dmcmd/STEELHAUS/STEELHAUS_User_Manual.docx

STEELHAUS

Heat Treat Kiln Controller

User Manual

For garage knifemakers and bladesmiths who want precise, repeatable heat treatment without a PhD in control systems.

# What Is STEELHAUS?

STEELHAUS is a touchscreen controller for your heat treat kiln. It lives on a Raspberry Pi inside or next to your oven, reads the thermocouple temperature through an ESP32, and controls the SSR (solid-state relay) that switches the heating element on and off.

The goal is simple: you tell it what temperature you want and it holds that temperature accurately and reliably, whether you are tempering a blade at 350°F, normalizing at 1475°F, or running a complex multi-step hardening program for D2 tool steel.

Unlike a basic PID controller that you buy off the shelf, STEELHAUS learns your specific oven over time. Every time you run it, it gets a little smarter about how your oven behaves, and it uses that knowledge to reach temperature faster, hold more precisely, and recover better when you open the door.

## What you need to know upfront

You do not need to understand PID control, relay autotuning, or thermal modeling to use this controller. The defaults work. The autotuning handles the math. This manual will explain why things work the way they do, but the short version is: run the setup steps once and then just use it.

The UI runs in a web browser. You access it by pointing any browser on your network to your oven's address. It is designed to be used on a touchscreen mounted on or near the oven, but it works fine on a phone or laptop too.

# Accessing the Controller

The controller runs as a web application on your Raspberry Pi. You access it through any web browser on the same network.

## Local network access

From the shop touchscreen | http://kiln.local:5000
From your phone or laptop | http://kiln.local:5000
If kiln.local does not work | Use the Pi's IP address instead, e.g. http://192.168.1.x:5000

## Remote access via Tailscale

If you have Tailscale installed on your Pi, you can access the controller from anywhere in the world using the Tailscale IP address. This lets you check on your oven from the house while a long temper cycle is running. See the Settings tab for Tailscale status.

NOTE: The controller is running whenever the Pi is powered on. It does not need to be open in a browser to control the oven.

## Connection indicator

The top-right corner of the interface shows a dot and the word LIVE (green) or CONNECTING (orange). If you see CONNECTING for more than a few seconds, check that the Pi is powered on and connected to the network.

# Dashboard Tab

The Dashboard is your main operating screen. Everything you need to run the oven day-to-day is here.

## Temperature display

The large number in the center of the screen is the current oven temperature. The color tells you at a glance what mode the oven is in:

- Blue — oven is cold or significantly below setpoint
- Orange — oven is at or near the setpoint
- Red — oven is approaching its maximum temperature limit

Below the main temperature you will see three smaller values:

SETPOINT | The target temperature the controller is trying to reach or hold
OUTPUT | The current heater output as a percentage (0% = off, 100% = full power)
COLD JXN | Cold junction temperature — the temperature at the thermocouple connection point on the ESP32. Normal to see 70–90°F when the oven is hot.

## Heater output bar

The orange bar below the temperature readings shows heater output visually. A label underneath tells you what phase the controller is currently in:

⚡ FULL POWER | Running at 100% to heat up as fast as possible
↘ Ramping Down | In the approach zone, reducing power as it nears setpoint
— Cruise | Holding at a steady intermediate output just before PID takes over
◎ PID Active | PID is in control, making fine adjustments to hold setpoint precisely
🔥 Door Recovery | Running at recovery boost power after door was opened
Ramp Rate | Running a program ramp segment, rate controller is active

## Manual Setpoint

Below the output bar is the Manual Setpoint box. This is how you set a temperature for manual operation (not using a program). Tap the number to open the numpad, enter your target temperature in degrees Fahrenheit, and confirm with SET. The oven will begin heating toward that temperature immediately once you press START.

NOTE: The numpad pre-fills with the current setpoint. Just start pressing digits — the first digit press automatically clears the old value so you do not have to hit CLEAR first.

## START / STOP button

The large button below the setpoint starts and stops the heater. When the heater is running it turns red and shows STOP. Press it to cut power, drop the contactor, and return the oven to manual mode.

NOTE: Pressing STOP during a program run aborts the program. The program itself is not deleted, just the current run.

## Contactor indicator

Below the START/STOP button is the Contactor status. The contactor is a heavy-duty relay that physically disconnects mains power from the heating element. When it shows green (Energized — AC live at SSRs), the element can be powered. When it shows red (De-energized — AC isolated), the element is completely disconnected from mains power regardless of what the SSR is doing. The contactor is always de-energized when the oven is stopped.

## Active PID Zone

When the heater is running, a section below the contactor shows the active PID zone — the set of tuning parameters the controller is currently using. This updates automatically as the oven moves through different temperature ranges.

## Program status (when a program is running)

When a heat treat program is running, the dashboard shows a program status panel above the manual setpoint box. This includes:

- Program name and current state (running, paused, etc.)
- Overall progress bar
- A step-by-step list of every segment in the program, showing which step is active, which are complete, and which are upcoming
- A progress bar for the current step
- Elapsed and remaining time
- Pause, Resume, and Abort buttons

Completed steps show a green checkmark and fade out. The active step highlights in orange (ramp) or blue (soak). Upcoming steps are dim.

# Programs Tab

Programs let you automate multi-step heat treat sequences. Instead of babysitting the oven through a normalize, then reheat, then soak, then quench sequence, you define the steps once and let the controller handle the timing.

## What is a program?

A program is a sequence of segments. Each segment is either a Ramp or a Soak:

RAMP | Heat up or cool down at a controlled rate, measured in degrees per minute. Example: ramp to 1475°F at 10°F per minute.
SOAK | Hold at a specific temperature for a set time, or hold indefinitely (Continuous) until you manually abort.

A typical knifemaking heat treat program might look like:

1. Ramp to 1475°F at 15°F/min (bring oven to hardening temperature)
2. Soak at 1475°F for 10 minutes (normalize the steel)
3. Ramp to 1925°F at 10°F/min (bring to austenitizing temperature)
4. Soak at 1925°F for 5 minutes (then quench — you abort at this point)

## Built-in programs

STEELHAUS comes with four pre-loaded programs:

1084 High Carbon | Ramp to 700°F for stress relief, then ramp to 1475°F and soak 10 minutes. For 1084 carbon steel hardening.
D2 Tool Steel | Multi-stage ramp through 930°F, 1470°F, and 1850°F with soaks at each level. For D2 air-hardening tool steel.
Temper 375°F | Two 60-minute temper cycles at 375°F. For most carbon steels after hardening.
Normalize 1084 | Single ramp to 1600°F with a 10-minute soak. For stress relief before final heat treat.

You can use these as-is or as starting points for your own custom programs.

## Creating a new program

1. Tap + New Program at the top of the Programs tab.
2. Tap the Program Name field to open the keyboard. Type a name (e.g. AEB-L Harden).
3. Optionally tap Description to add notes.
4. Tap Add Ramp or Add Soak to add your first segment.
5. For each segment, set the target temperature and either the ramp rate (for ramps) or the hold time (for soaks).
6. Tap Save Program when done.

TIP: For the soak that ends with a quench, set it to Continuous. The program will hold at temperature until you tap Abort, at which point you pull the blade and quench.

## Editing a program

Tap any program in the list to open its detail view, then tap the pencil (edit) button. You can change the name, description, and any segment. Tap Save when done.

## Running a program

From the program list, tap the green play button next to the program you want to run. The controller switches to the Dashboard and begins the program immediately.

You can also open a program's detail view and tap Run Program from there.

## Ramp segments in detail

When a ramp segment is running, the rate controller takes over from the normal PID. It measures the actual rate of temperature rise using a rolling average of recent temperature readings, compares that to your target rate, and adjusts output to match. This means:

- The oven actually heats at the rate you specified, not just chases a moving setpoint
- If the oven is climbing faster than the target rate, output is reduced
- If it is climbing slower, output is increased

Before the ramp starts, the controller waits in preheat mode until the oven is already rising at least 20% of the target rate. This prevents the ramp clock from getting ahead of a cold oven.

## Soak segments in detail

When a ramp finishes and a soak begins, the controller looks up the thermal model (see Thermal Model section) to find out approximately what output is needed to hold that temperature. It seeds the PID with that value so there is no dip or overshoot at the transition.

## Continuous soak

A soak with Continuous enabled holds indefinitely. The program will not advance past it on its own. Use this for the final soak before a quench: when you are ready, tap Abort on the dashboard. The program ends, the oven shuts off, and you quench.

## Pausing and resuming

You can pause a running program using the Pause button on the dashboard. The timer stops and the oven holds at the current setpoint. Tap Resume to continue. Note that pausing during a ramp leaves the setpoint where it was — it will not back up when you resume.

## Aborting a program

The Abort button stops the program immediately. The heater is cut, the contactor drops, and the controller returns to a stopped state. The program itself is saved and can be run again.

# PID Tab

The PID tab is where you manage the tuning data that makes the controller work well. Most of this is set up once and then left alone. If you see the word PID and your eyes glaze over, just know that PID is the algorithm that decides how much power to apply at any given moment to hold the temperature accurately. The tuning process teaches it how your specific oven behaves.

## PID Zone Map

A kiln does not behave the same way at 350°F as it does at 1925°F. At low temperatures it heats up quickly and easily. At high temperatures it loses heat to radiation much faster and needs more aggressive control. PID zones let you tune the controller at different temperatures so it behaves well across the full range.

Each zone stores three tuning values (Kp, Ki, Kd) for a specific temperature. When the oven is between two zones, the controller interpolates smoothly between them. You do not need zones at every temperature — two or three well-placed zones cover the full range.

Recommended zones for knifemaking:

- 350°F — covers tempering
- 1000°F — covers normalizing
- 1925°F — covers hardening

The active zone is highlighted in orange in the zone table while the oven is running.

## Run Autotune for a Zone

Autotuning is how the controller learns the right PID values for your oven at a specific temperature. You never need to calculate Kp, Ki, or Kd yourself.

How it works:

1. You set a target temperature and tap Start Autotune.
2. The oven heats to that temperature using a full-power preheat.
3. Once near temperature, the controller switches to a relay test: it deliberately oscillates the output between high and low, inducing a controlled oscillation in the oven temperature.
4. After 5 complete oscillations, it calculates the right PID values from the oscillation characteristics and presents them for you to save.

The process takes 30–60 minutes depending on temperature.

When to autotune

Run autotune when you first set up the controller, and again if you replace the heating element, change the insulation, or notice the oven is over- or under-shooting significantly at a temperature you use regularly.

## Choosing an autotune method

When you start an autotune, you pick a tuning method. The method determines how aggressively the resulting PID will respond. Think of it like a suspension setting on a car — stiffer is faster but bumpier; softer is smoother but slower to react.

All five methods use the same oscillation data from the relay test. They just apply different formulas to convert that data into Kp, Ki, and Kd values. Here is what each one does in plain terms:

### Steelhaus (recommended)

This is the default and the one you should use. It was tuned specifically for heat treat kilns like this one, based on real-world runs. It uses conservative gains that produce a clean single slight overshoot of about 5°F, then locks right on to the setpoint with no further oscillation. It also includes a small derivative term (Kd) that helps prevent the oven from drifting when something changes, like putting a cold blade in the oven.

Use this for: everything, unless you have a specific reason to try another method.

### Ziegler-Nichols

Ziegler-Nichols is the classic tuning method from 1942 and is the basis for most other methods. It is aggressive — it pushes for fast response and is willing to accept 25% overshoot to get there quickly. For a heat treat kiln this is usually too aggressive. Your oven will reach temperature faster but will swing above and below the setpoint more before settling.

Use this for: situations where you need the fastest possible response to temperature changes and can tolerate overshoot, such as a very small oven with little thermal mass.

NOTE: Ziegler-Nichols at 1925°F is likely to produce noticeable overshoot. You probably do not want that when hardening a blade.

### Tyreus-Luyben

Tyreus-Luyben was developed specifically to reduce the oscillation that Ziegler-Nichols produces. It is more conservative, uses no derivative term (Kd=0), and tends to produce a slow, smooth approach with minimal overshoot but also a slower response to disturbances. It is a good choice if your oven is prone to oscillating around setpoint with other methods.

Use this for: an oven that oscillates noticeably at setpoint with Steelhaus or Ziegler-Nichols. It trades some responsiveness for smoother, more stable holding.

### Some Overshoot

A middle ground between Tyreus-Luyben and Ziegler-Nichols. Expects about 15% overshoot on the way up to setpoint, then settles. More aggressive than Tyreus-Luyben but less so than Ziegler-Nichols. No derivative term. Most kilns with good approach control zones do not benefit from this method over Steelhaus.

Use this for: experimenting if Steelhaus is not holding well and you want to try something more aggressive than Tyreus-Luyben.

### No Overshoot

The most conservative method. Uses the smallest proportional gain of any option, producing a very slow, gentle approach to setpoint with essentially zero overshoot. The downside is slow response — if something disturbs the temperature (opening the door, putting a cold blade in), it will take longer to recover. Also no derivative term.

Use this for: applications where any overshoot is completely unacceptable. Rarely needed for knifemaking. If you are doing precision tempering where even 5°F overshoot would matter, this is worth trying.

### Summary table

Method | Character
Steelhaus | ★ Recommended — 5°F overshoot, fast settle, includes Kd
Ziegler-Nichols | Aggressive — fast but ~25% overshoot, includes Kd
Tyreus-Luyben | Smooth — very little overshoot, slow response, no Kd
Some Overshoot | Middle ground — ~15% overshoot, no Kd
No Overshoot | Ultra-conservative — creeps to setpoint, slowest recovery, no Kd

TIP: If you are unsure which to pick, use Steelhaus. If your oven is noticeably oscillating at setpoint after autotuning with Steelhaus, try Tyreus-Luyben at that zone. If it is taking a very long time to reach setpoint and not responding well to disturbances, try Ziegler-Nichols.

## Ramp Rate Autotune

The ramp rate autotune teaches the controller how fast your oven responds to changes in output at a given temperature. This information is used to control ramp segments accurately.

How it works:

1. Set a stabilize temperature (the temperature at which the test will run).
2. Set the step output percentage (default 50% — this is the power level used in the test).
3. Set the step duration in minutes (default 6 minutes).
4. Tap Start Ramp Autotune.
5. The oven heats to the stabilize temperature using normal PID control (with your tuned zones).
6. Once stable, the controller locks the output to the step percentage for the full duration and records how quickly the temperature rises.
7. From this data it calculates the gains for the ramp rate controller and presents them to save.

Run ramp autotune at temperatures where you will use ramps — typically 350°F and 1000°F. Once you have zones at multiple temperatures, the controller interpolates between them for ramps at intermediate temperatures.

NOTE: You must have at least one PID zone tuned before running the ramp autotune, because the stabilize phase uses PID to reach temperature.

## Ramp Tune Zones table

This table shows your saved ramp tune data. Columns:

Temp | The temperature at which the autotune was run
Kp / Ki | The rate controller gains calculated from the test
K (°/min/%) | Process gain — how many degrees per minute the oven rises per percent of output. A higher K means the oven responds faster at that temperature.
Lag (s) | How many seconds it takes the oven to start responding after a change in output
Hold % | The measured steady-state output needed to hold that temperature (used to seed control transitions)

## Thermal Model

The thermal model is STEELHAUS's memory of how your oven behaves from real use. Every time the oven holds a temperature steadily in PID mode (not ramping, door closed, temperature within 3°F of setpoint, output stable for at least 60 seconds), the controller quietly records the output level required. It does this every 30 seconds.

Over time, the model builds up a picture of how much power your oven needs to hold any temperature. This data is stored permanently and survives restarts.

The thermal model is used in four places:

- When you start the oven at a setpoint, the PID integral is seeded from the model so it does not have to wind up from zero
- When a ramp transitions to a soak, the PID starts at the model's estimated hold power for that temperature
- During approach control, the cruise power phase is refined using the model
- During door recovery, the taper target uses the model's hold power estimate

The table shows each anchor temperature (rounded to the nearest 5°C), the current hold estimate, how many observations went into it, and when it was last updated. The more samples, the more reliable the estimate.

TIP: Let the oven run a long soak at each temperature you use regularly. An hour at 1925°F gives the model 60+ observations and produces a very accurate estimate.

The Clear Model button wipes all thermal model data. Use this if you make significant changes to your oven such as replacing the element or adding insulation, as the old data will no longer apply.

## Manual PID Override

This lets you temporarily set specific Kp, Ki, Kd values without saving them as a zone. Useful for experimenting or troubleshooting. The override applies immediately and stays in effect until the oven is stopped, at which point the controller returns to the interpolated zone values.

# Chart Tab

The Chart tab shows a live temperature chart of the current session and lets you review past sessions. This is where you can see exactly how a heat treat run went.

## Reading the chart

Three lines are plotted:

Orange solid | Actual oven temperature
Blue dashed | Setpoint (the target temperature)
Blue solid segment | Door open indicator — a vertical line appears when the door was opened

The horizontal axis shows time. The vertical axis shows temperature. Grid lines are spaced evenly to make it easy to read.

## Chart modes

LIVE | Shows the last 25 minutes of data, updating in real time. The chart scrolls as time passes.
REVIEW | Pauses live updates so you can pan and zoom to examine any part of the history.
FIT | Zooms to fit all data in the current session into the visible area.
X | Clears the tap-to-read cursor if it is active.

## Tap to read values

In REVIEW or FIT mode, tap anywhere on the chart to see the exact temperature, setpoint, and output at that moment. A vertical cursor line appears and the values show at the bottom.

## Navigation controls

The two rows of buttons below the chart let you pan and zoom:

⏪ / ⏩ | Jump to beginning / end of data
◄ / ► | Pan left / right by one screen width
+ / − | Zoom in / zoom out (time axis)
▲▲ / ▼▼ | Pan up / down by a large amount (temperature axis)
▲ / ▼ | Pan up / down by a small amount
↕+ / ↕− | Expand / contract the temperature axis (zoom vertically)

## Sessions

Every time the controller service starts (including after a power cycle), a new session begins. The session dropdown at the top lets you switch between the current session and all past sessions.

+ NEW creates a new session manually without restarting. Use this to start a fresh chart when beginning a new heat treat sequence in the same day.

## Session Manager

The ⚙ MANAGE button opens the Session Manager, which gives you tools to clean up old sessions:

Stats | Shows total sessions, total log rows, and oldest session date
Purge by age | Deletes all sessions older than a specified number of days. Protected sessions are not affected.
Batch select | Lets you check individual sessions and delete them in one operation. Quick select buttons let you grab all, none, or sessions older than 30/90 days.
Lock icon | Tap the lock icon on any session row to protect it from deletion. Locked sessions survive purge and batch delete.

TIP: Lock any session where something important happened, like a first successful AEB-L hardening run, so you can always refer back to exactly how it went.

# Settings Tab

The Settings tab contains configuration options that you set once and rarely change.

## Approach Control Zones

Approach control is the system that gets the oven to temperature smoothly without overshooting. Without it, the oven would blast at full power all the way to setpoint, overshoot, then oscillate. Approach control solves this by switching from full power to a controlled cruise as it nears the target.

The approach phases:

1. FULL POWER — 100% output until the oven is within full_power_offset degrees of setpoint
2. RAMP DOWN — output linearly reduces from 100% to cruise level over the ramp_start_offset window
3. CRUISE — fixed output just below the hold power, letting the oven coast to setpoint
4. PID — PID takes over when within pid_offset degrees of setpoint

Each zone is defined at a specific temperature. The controller interpolates between zones. You can tune at 350°F, 1000°F, and 1925°F to cover the full range.

The cruise power is automatically refined using the thermal model when data is available, so the approach improves over time even if you leave the zone settings alone.

Do I need to tune approach zones?

If your oven is consistently overshooting significantly when heating up from cold, tuning approach zones will help. If the overshoot is minor (a few degrees) and settles quickly, the default behavior or your existing zones are fine.

The Enable toggle turns approach control on or off globally. Leave it on unless you are deliberately testing without it.

## Door Recovery Zones

When you open the oven door to put a blade in for hardening, the temperature drops immediately. Door recovery tells the controller how to respond when you close the door.

The new door recovery system is temperature-based, not time-based. You specify two things:

Boost % | How hard to push the heater during recovery. 100% is full power. For 1925°F where thermal mass is high, 100% is appropriate.
Resume within X°F of setpoint | How close the oven temperature must get before the controller stops boosting and hands back to normal PID. Example: 10°F means recovery ends when the oven is within 10°F of setpoint.

When you close the door, the controller immediately applies the boost output. It watches the temperature. When the oven gets back within your specified offset of setpoint, the boost ends and PID resumes — seeded from the thermal model so it picks up smoothly.

This approach is smarter than a fixed time boost because it adapts automatically to how long the door was open. Quick check — small drop — recovery ends quickly. Long blade insertion with cold metal inside — bigger drop — recovery runs until the oven genuinely returns.

TIP: For 1925°F hardening, a good starting point is Boost 100%, Resume within 10°F. Adjust based on how your runs go.

## Display Unit

Switch between Fahrenheit and Celsius. All temperatures in the UI, charts, and programs display in the selected unit. Internally, the controller always works in Celsius.

## Maximum Temperature Limit

A hard safety limit. If the oven temperature exceeds this value, the controller immediately cuts the heater and drops the contactor. Default is 2100°F. Set it to a safe margin above your highest normal operating temperature.

NOTE: This is a software limit. The hardware door interlock (normally-open door switch wired in series with the contactor coil) operates independently of software.

## Autotune Power Settings

These two multipliers adjust how aggressively the autotune heats during its preheat phase. You generally do not need to change these.

Cruise Power Multiplier | Scales the cruise output during autotune preheat. Default 1.0. Increase if the oven is not reaching setpoint during preheat.
Relay Power Multiplier | Scales the relay output during the oscillation phase. Default 1.0.

## Temperature Calibration Offset

If you have verified with a calibrated reference thermometer that your thermocouple reads consistently high or low, you can apply a fixed offset here. Positive values make the displayed temperature higher; negative values make it lower. The offset is applied to all readings before display and control.

NOTE: Use this carefully. An incorrect offset will affect all control decisions. If you are unsure, leave it at 0.

## Simulation Mode

Simulation mode lets the UI run as if an oven were connected, without any actual hardware. Temperatures are simulated mathematically. Useful for testing programs or learning the interface without needing the hardware running.

When simulation mode is active, a yellow border appears around the entire interface and the logo turns yellow. All controls work normally but nothing happens in the real world.

## Remote Access — Tailscale

This section shows the status of your Tailscale connection. Tailscale is a VPN service that lets you access devices on your home network from anywhere. If installed on your Pi, you can monitor your oven from the house, a show, or anywhere with internet.

See tailscale.com for installation instructions. Once installed and connected, your controller will be accessible at its Tailscale IP address from any of your Tailscale devices.

## System

The System section includes:

Restart Service | Restarts the controller software without rebooting the Pi. Use this after updating files.
Reboot Pi | Fully reboots the Raspberry Pi.
Version info | Shows the current software version if configured.

# First-Time Setup Guide

Follow these steps when you are setting up STEELHAUS for the first time, or starting fresh with a new oven.

## Step 1: Set your maximum temperature

Go to Settings and set the Maximum Temperature Limit to something safely above your highest operating temperature. For knifemaking at up to 1925°F, 2100°F is appropriate.

## Step 2: Run PID autotune at your key temperatures

Go to the PID tab and run autotune at each temperature you use regularly:

1. Tap Run Autotune for a Zone.
2. Enter a target temperature (start with 350°F for tempering).
3. Select the Steelhaus tuning method.
4. Tap Start Autotune and let it run. This takes 30–60 minutes.
5. When it shows results, tap Save Zone.
6. Repeat for 1000°F and 1925°F (or whatever temperatures you use).

With three zones, the controller will interpolate accurately for any temperature between them.

## Step 3: Run ramp rate autotune

Go to the Ramp Rate Autotune section of the PID tab and run a test at 350°F and 1000°F:

1. Set the stabilize temperature.
2. Leave step output at 50% and duration at 6 minutes.
3. Tap Start Ramp Autotune and let it run. Takes about 15–25 minutes.
4. Save the zone when results appear.

## Step 4: Set up door recovery

Go to Settings, Door Recovery Zones, and tap + Add Door Recovery Zone:

1. Enter your hardening temperature as the setpoint (e.g. 1925°F).
2. Set Boost % to 100.
3. Set Resume within to 10°F.
4. The zone saves automatically.

## Step 5: Let the thermal model build

Run your first few heat treat sessions normally. Hold the oven at each operating temperature for at least 30–60 minutes. Check the Thermal Model table in the PID tab — you should see entries appearing and sample counts growing. After a few sessions the model will be well-populated and the controller will be noticeably smoother.

## Step 6 (optional): Set up approach control

If you notice significant overshoot when the oven heats up from cold, go to Settings and add approach control zones. The defaults are reasonable for most kilns but tuning at your key temperatures gives the best results.

# Common Heat Treatment Sequences

This section describes how to set up STEELHAUS for common knifemaking heat treatment operations. These are general guidelines — always consult your steel's spec sheet for exact temperatures and times.

## Simple temper (most common steels)

After hardening and quenching, blades need to be tempered promptly. The tempering temperature depends on the desired hardness and the steel.

1. Let the blade cool to room temperature after quenching (or to below 150°F for most steels).
2. On the dashboard, tap the manual setpoint and enter your tempering temperature (commonly 350°F–400°F).
3. Tap START.
4. Wait for the oven to reach and stabilize at temperature.
5. Place the blade in the oven.
6. Set a timer for your soak time (typically 1–2 hours per cycle, two cycles recommended).
7. When done, turn off the oven and let the blade air cool in the oven.

TIP: Use a Soak program segment with a timer for precise temper cycles. The built-in Temper 375°F program does two 60-minute cycles automatically.

## Normalizing (1084 and similar simple carbon steels)

Normalizing relieves stress from forging and aligns the grain structure before hardening.

1. Ramp to 100°F above the hardening temperature (for 1084, about 1600°F).
2. Soak for 10 minutes.
3. Remove the blade and let it air cool.
4. Repeat 2–3 times for best results.

The built-in Normalize 1084 program handles a single cycle. Create a custom program for multiple cycles or different steels.

## Hardening (1084 at 1475°F)

1. Normalize the blade (see above).
2. Let cool to room temperature.
3. Preheat the oven to 1475°F.
4. Place the blade on a piece of stainless steel foil or in a foil envelope to prevent scale.
5. Insert the blade. Close the door.
6. Let it soak for 5–10 minutes to fully austenitize.
7. Remove quickly and quench in warm Parks 50 or canola oil.
8. Immediately start tempering.

## Hardening (AEB-L and similar stainless at 1925°F)

1. Preheat oven to 1600°F and soak for 20 minutes (equalization soak).
2. Ramp to 1925°F.
3. Soak for 5–10 minutes (short soaks preserve fine carbides).
4. Plate quench or interrupted quench per steel specifications.
5. Temper immediately at 350°F for 2 hours minimum.

Use a Continuous soak at the hardening temperature so you can control exactly when to quench. When you are ready, tap Abort and go.

# Troubleshooting

## Oven not heating after I press START

Check the following:

- The contactor indicator shows green (Energized). If it shows red, the contactor command did not reach the ESP32. Try pressing STOP then START again.
- The ESP32 is connected (no fault messages in the dashboard).
- The door switch is not showing the door as open if the door is actually closed.
- There are no active thermocouple faults. Check the fault code display.

## Temperature drops to zero or shows a fault

A thermocouple fault usually means:

- Open thermocouple: the thermocouple wire is broken or disconnected.
- Temperature too high/low: the reading is outside the MAX31856 chip's measurement range.
- Overvoltage: there may be interference on the SPI lines, often from SSR switching noise.

The controller will shut down the heater on any thermocouple fault.

## Oven overshoots significantly on heat-up

This usually means approach control is not configured for this temperature, or the cruise power is set too high. Go to Settings and add or adjust an approach control zone for this temperature. Also make sure the thermal model has data at this temperature — the cruise power is refined automatically once the model has observations.

## Temperature dips when transitioning from a ramp to a soak

The thermal model needs more data at the soak temperature. Run a manual soak at that temperature for at least an hour to build up the model. The ramp-to-soak transition uses the thermal model to seed the PID at the right starting output — without that data it uses a fallback estimate.

## Ramp is not following the target rate

Run the ramp rate autotune at a temperature close to the ramp range. Without tuned ramp zones, the controller uses default gains that may not match your oven's characteristics.

## Oven oscillates at setpoint

The PID gains for this temperature zone may be too aggressive. Either re-run the autotune (it may produce better results on a second attempt) or use the Manual PID Override to reduce Kp until the oscillation stops, then re-tune.

## Chart shows periodic spikes in temperature

This is typically electrical noise from the SSR switching coupling into the thermocouple reading. The 3-sample median filter in the software reduces this significantly. If you still see it, check that the thermocouple wiring is routed away from the SSR and mains wiring. Shielded thermocouple wire helps.

## UI says Connecting and never connects

The controller service may not be running on the Pi. SSH into the Pi and check the service status:

ssh pi@kiln.local

sudo systemctl status kiln-controller

If it is not running, start it with: sudo systemctl start kiln-controller

To start automatically on boot: sudo systemctl enable kiln-controller

# Quick Reference

## Starting a manual heat

1. Enter setpoint on dashboard (tap the number, type temp, tap SET).
2. Tap START.
3. Watch the approach phases (Full Power → Ramp Down → Cruise → PID).
4. When done, tap STOP.

## Running a program

1. Go to Programs tab.
2. Tap the green play button on the program you want.
3. Monitor progress on the dashboard.
4. For continuous soaks, tap Abort when ready to quench.

## After opening the door

Nothing special required. If door recovery is configured, it activates automatically when the door closes. The controller handles the rest.

## Key temperatures for common steels

1084 carbon steel — harden | 1475°F (802°C), soak 5–10 min, oil quench
1084 carbon steel — temper | 375°F (190°C), 1 hour, two cycles
1084 carbon steel — normalize | 1600°F (871°C), soak 10 min, air cool
AEB-L stainless — harden | 1925°F (1052°C), soak 5–10 min, plate quench
AEB-L stainless — temper | 350°F (177°C), 2 hours, two cycles
D2 tool steel — harden | 1850°F (1010°C), soak 30 min, air cool
D2 tool steel — temper | 350°F–400°F, 2 hours, two cycles

NOTE: These are starting points. Always verify against your specific steel's data sheet and adjust based on your results.

## Recommended tuning order

1. PID autotune at 350°F
2. PID autotune at 1000°F
3. PID autotune at 1925°F (or highest temperature you use)
4. Ramp rate autotune at 350°F
5. Ramp rate autotune at 1000°F
6. Door recovery zone at your hardening temperature
7. Run several sessions to build the thermal model
8. Approach control zones (optional, if overshoot is a problem)

# Hardware Overview

This section briefly describes the hardware components that STEELHAUS controls. You do not need to understand all of this to use the controller, but it helps explain why things work the way they do.

## The main components

Raspberry Pi 4 | The brain. Runs the STEELHAUS software, serves the web interface, and communicates with the ESP32.
ESP32 microcontroller | Handles the fast, real-time tasks: reading the thermocouple via SPI, driving the SSR via PWM, and monitoring the door switch and E-stop. Communicates with the Pi via UART serial.
MAX31856 thermocouple chip | Converts the thermocouple voltage to a temperature reading with cold-junction compensation. Handles 50Hz/60Hz noise rejection internally.
SSR (Solid State Relay) | Switches the heating element on and off. The ESP32 PWM signal controls the duty cycle — how much of each cycle the element is powered.
Contactor | A heavy-duty relay that physically disconnects mains power from the SSRs. Acts as a master on/off switch for AC power. The software drops the contactor whenever the heater is stopped.
Door switch | A normally-open switch wired in two places: in series with the contactor coil (hardware interlock that physically prevents the contactor from energizing when the door is open) and to the ESP32 for software monitoring.
Power supplies | Two DIN-rail supplies: 5V for logic and 24V for the contactor coil and SSR control signal.

## The hardware safety chain

STEELHAUS has two independent layers of safety:

- Hardware: the door switch is wired in series with the 24V contactor coil. When the door is open, the contactor physically cannot energize regardless of what the software does.
- Software: the controller monitors the door switch and disables heating in software when the door is open, independently of the hardware interlock.

This two-layer approach means the oven cannot be powered if the door is open, even if a software bug occurs.

STEELHAUS — Heat Treat Kiln Controller

For questions or updates, refer to the project documentation.
