dmcmd/STEELHAUS/STEELHAUS_Wiring.docx

# STEELHAUS — Complete Wiring Diagram

Heat Treat Oven Controller | Raspberry Pi 4 + ESP32 + MAX31856

Pi ↔ ESP32 (UART only)
FROM | TO
Pi Pin 8 (GPIO14 TX) | ESP32 GPIO16 (RX2)
Pi Pin 10 (GPIO15 RX) | ESP32 GPIO17 (TX2)

NOTE: TX always crosses to RX. Pi TX → ESP32 RX, Pi RX → ESP32 TX. Pi and ESP32 are NOT powered from each other — each has its own 5V connection from the MDR-60-5.

ESP32 ↔ MAX31856 (SPI)
FROM | TO
ESP32 GPIO5 | MAX31856 CS
ESP32 GPIO18 | MAX31856 SCK
ESP32 GPIO19 | MAX31856 MISO (SDO)
ESP32 GPIO23 | MAX31856 MOSI (SDI)
ESP32 3.3V | MAX31856 VCC
ESP32 GND | MAX31856 GND

NOTE: Use 3.3V for MAX31856 VCC — NOT 5V.

ESP32 → SSR MOSFET (IRLZ44N #1)
FROM / CONNECTION | TO / NOTES
ESP32 GPIO27 | 100Ω resistor → IRLZ44N #1 Gate
IRLZ44N #1 Gate | 10kΩ resistor → GND (pull-down)
IRLZ44N #1 Source | GND
MDR-60-24 (+24V) | SSR1 DC+ input
SSR1 DC− output | SSR2 DC+ input (series connection)
SSR2 DC− output | IRLZ44N #1 Drain

NOTE: SSRs are wired in series on the DC control side. 24V drives through both SSR inputs to the MOSFET drain.

SSR AC Outputs → Heating Element
FROM | TO
Contactor T1 | SSR1 AC input
SSR1 AC output | Heating Element Leg 1
Contactor T2 | SSR2 AC input
SSR2 AC output | Heating Element Leg 2

NOTE: Contactor sits upstream of both SSRs as master AC disconnect.

ESP32 → Contactor MOSFET (IRLZ44N #2)
FROM / CONNECTION | TO / NOTES
ESP32 GPIO33 | 100Ω resistor → IRLZ44N #2 Gate
IRLZ44N #2 Gate | 10kΩ resistor → GND (pull-down)
IRLZ44N #2 Source | GND
IRLZ44N #2 Drain | Contactor A2 (coil −)

NOTE: LC1D32BD coil: A1 = coil (+), A2 = coil (−). The coil has a built-in flyback diode.

Door Switch → Contactor (Hardware Safety — No Software)
FROM | TO
MDR-60-24 (+24V) | Door Switch NO contact (pole 1)
Door Switch NO contact (pole 1) | Contactor A1 (coil +)

NOTE: Normally-Open contact. Door closed = switch pressed = circuit complete = contactor energized. Door open = circuit broken = contactor drops out. 100% hardwired, no microcontroller involved.

Door Switch → ESP32 (Software Awareness)
FROM / CONNECTION | TO / NOTES
ESP32 3.3V | Door Switch NC contact (pole 2)
Door Switch NC contact (pole 2) | ESP32 GPIO35
ESP32 GPIO35 | 10kΩ resistor → GND (pull-down)

NOTE: NC contact: door closed = open = GPIO35 LOW (normal). Door open = closed = GPIO35 HIGH = dashboard alert + outputs cut.

E-Stop Button (Normally-Closed)
FROM / CONNECTION | TO / NOTES
ESP32 3.3V | NC button terminal 1
NC button terminal 2 | ESP32 GPIO34
ESP32 GPIO34 | 10kΩ resistor → GND (pull-down)

NOTE: Button intact (closed) = GPIO34 HIGH = normal. Button pressed or wire break = GPIO34 LOW = immediate E-Stop.

Shutdown Button (Normally-Open, Pi GPIO21)
FROM | TO
Pi GPIO21 (Pin 40) | NO button terminal 1
NO button terminal 2 | GND

NOTE: Press and hold initiates graceful Pi shutdown. Pi has internal pull-up on GPIO21.

Contactor (Mains AC Power)
FROM | TO
Mains Hot Leg 1 | Contactor L1
Mains Hot Leg 2 | Contactor L2
Contactor T1 | SSR1 AC input
Contactor T2 | SSR2 AC input

NOTE: WARNING: L1/L2/T1/T2 are mains voltage (240V AC). Follow all electrical codes. Use appropriately rated wire and terminals.

MDR-60-5 (5V Supply — Logic Power)
FROM | TO
MDR-60-5 (+5V) | Pi GPIO Pin 2 or 4 (5V)
MDR-60-5 (+5V) | ESP32 VIN
MDR-60-5 (−) | GND bus

NOTE: MDR-60-5 powers all logic: Raspberry Pi 4 (up to 3A) and ESP32 (up to 0.5A). Total draw well within 10A capacity. Pi and ESP32 are wired directly to the supply, not to each other.

MDR-60-24 (24V Supply — Control Power)
FROM | TO
MDR-60-24 (+24V) | Door Switch NO contact (contactor coil circuit)
MDR-60-24 (+24V) | SSR1 DC+ input (SSR control circuit)
MDR-60-24 (+24V) | Fan 1 red wire (+)
MDR-60-24 (+24V) | Fan 2 red wire (+)
MDR-60-24 (−) | GND bus

NOTE: MDR-60-24 powers all 24V loads: contactor coil (~225mA), SSR control inputs (~30mA), fans (~400mA). Total draw ~655mA, well within 2.5A capacity.

Cooling Fans (24V DC)
FROM | TO
MDR-60-24 (+24V) | Fan 1 red wire (+)
MDR-60-24 (+24V) | Fan 2 red wire (+)
Fan 1 black wire (−) | GND bus
Fan 2 black wire (−) | GND bus

NOTE: Alinan 8025 80mm 24V dual ball bearing fans, 0.2A each. Connect directly to 24V supply.

Thermocouple (K-Type)
FROM | TO
K-type (+) yellow wire | MAX31856 T+ terminal
K-type (−) red wire | MAX31856 T− terminal

NOTE: Keep thermocouple wires away from AC mains wiring to prevent noise coupling into temperature readings.

GND Bus (All Grounds Tied Together)
CONNECTION | NOTES
MDR-60-5 (−) | 5V supply negative
MDR-60-24 (−) | 24V supply negative
Pi GPIO Pin 6 (GND)
ESP32 GND
MAX31856 GND
IRLZ44N #1 Source | SSR MOSFET
IRLZ44N #2 Source | Contactor MOSFET
SSR2 DC− | End of SSR series chain
Fan black wires | Both fans
Chassis / safety ground | Connect to enclosure metal

NOTE: Run a dedicated GND bus bar or terminal strip. Land all grounds here. Chassis ground ties electrical safety ground to the enclosure.

ESP32 GPIO Summary

GPIO | Function | Connected To
GPIO4 | MAX31856 DRDY | Not connected (optional)
GPIO5 | MAX31856 CS | MAX31856 CS pin
GPIO16 | UART2 RX | Pi GPIO14 (TX)
GPIO17 | UART2 TX | Pi GPIO15 (RX)
GPIO18 | MAX31856 SCK | MAX31856 SCK pin
GPIO19 | MAX31856 MISO | MAX31856 SDO pin
GPIO23 | MAX31856 MOSI | MAX31856 SDI pin
GPIO27 | SSR output | IRLZ44N #1 gate via 100Ω
GPIO33 | Contactor output | IRLZ44N #2 gate via 100Ω
GPIO34 | E-Stop input | NC button + 10kΩ pull-down
GPIO35 | Door switch input | Door switch NC contact + 10kΩ pull-down

Generated by STEELHAUS project — Raspberry Pi 4 + ESP32 + MAX31856
