dmcmd/STEELHAUS/(commit log)

2026-06-21 Reset recovery and door state on heater disable
    Reset recovery and door state variables when heater is disabled.
    [controller.py]
2026-06-21 Enhance recovery mode with entry temperature tracking
    Added recovery entry temperature tracking and conditions to manage recovery state.
2026-06-28 Remove cage wrapper and update xinitrc.sh for rotation
    Removed cage wrapper script due to display rotation and touchscreen calibration issues on Pi 4 Bookworm. Updated xinitrc.sh to handle display rotation and touch input configuration.
2026-06-28 Refactor setup script for xinit and touchscreen support
    Removed cage installation and related comments, switched to xinit for display management, and updated touch input calibration rules for USB touchscreens.
2026-06-29 Refactor setup.sh for kiosk enhancements
    Updated setup script for kiosk configuration on Raspberry Pi. Adjusted package installations, display rotation settings, and touch input calibration for improved compatibility.
2026-06-30 Refactor setup script for xinit/X11 and USB touchscreens
    Removed cage installation and related configurations, switched to xinit/X11 for display management, and updated touch input calibration rules for USB touchscreens.
2026-06-30 Adjust simulation temperature output calculation
